ALTAIR-McGill-x-UVictoria/HAB-Control-Flight-Computer/README.md

# HAB-Control-Flight-Computer
High Altitude Balloon Flight Computer
