ALTAIR-McGill-x-UVictoria/HAB-Control-Flight-Computer/flight-computer-hardware/README.md

# Hardware Information

Flight computer PCB designed on KiCad, a free PCB design software.
