ALTAIR-McGill-x-UVictoria/HAB-Control-Flight-Computer/flight-computer-software/test/test_model/test_model_output_log.txt

=~=~=~=~=~=~=~=~=~=~=~= PuTTY log 2025.04.07 14:20:27 =~=~=~=~=~=~=~=~=~=~=~=
Successfully initialized all sensors.
ESCs ready
ESCs calibrated
Initializing TensorFlow Lite Micro Interpreter...
Model initialization done.
Starting mission...
time: 110023, xAcc: -0.02, yAcc: -0.01, vx: 0.17, vy: 0.02, px: 1.29, py: -0.08, roll: -0.06, pitch: -0.02, yaw: -1.04, xAngVel: 0.00, yAngVel: 0.01, zAngVel: 0.02, prevA0: 0.00, prevA1: 0.00, diffA0: 0.00, diffA1: 0.00, motor0: 0.52, motor1: 0.53
time: 110038, xAcc: -0.02, yAcc: -0.01, vx: 0.17, vy: 0.02, px: 1.29, py: -0.08, roll: -0.06, pitch: -0.02, yaw: -1.04, xAngVel: 0.01, yAngVel: 0.01, zAngVel: 0.01, prevA0: 0.52, prevA1: 0.53, diffA0: -0.52, diffA1: -0.53, motor0: 0.51, motor1: 0.53
time: 110045, xAcc: -0.02, yAcc: -0.01, vx: 0.17, vy: 0.01, px: 1.29, py: -0.08, roll: -0.06, pitch: -0.02, yaw: -1.04, xAngVel: 0.01, yAngVel: 0.01, zAngVel: 0.01, prevA0: 0.51, prevA1: 0.53, diffA0: 0.01, diffA1: -0.01, motor0: 0.52, motor1: 0.53
time: 110075, xAcc: -0.02, yAcc: -0.01, vx: 0.17, vy: 0.01, px: 1.30, py: -0.08, roll: -0.06, pitch: -0.02, yaw: -1.04, xAngVel: 0.01, yAngVel: 0.01, zAngVel: 0.01, prevA0: 0.52, prevA1: 0.53, diffA0: -0.00, diffA1: 0.00, motor0: 0.52, motor1: 0.53
time: 110103, xAcc: -0.02, yAcc: -0.01, vx: 0.17, vy: 0.01, px: 1.30, py: -0.08, roll: -0.06, pitch: -0.02, yaw: -1.04, xAngVel: 0.01, yAngVel: 0.01, zAngVel: 0.01, prevA0: 0.52, prevA1: 0.53, diffA0: 0.00, diffA1: -0.00, motor0: 0.52, motor1: 0.53
time: 110124, xAcc: -0.02, yAcc: -0.01, vx: 0.17, vy: 0.01, px: 1.31, py: -0.07, roll: -0.06, pitch: -0.02, yaw: -1.04, xAngVel: 0.00, yAngVel: 0.01, zAngVel: 0.01, prevA0: 0.52, prevA1: 0.53, diffA0: -0.00, diffA1: 0.00, motor0: 0.52, motor1: 0.53
time: 110140, xAcc: -0.02, yAcc: -0.01, vx: 0.17, vy: 0.01, px: 1.31, py: -0.07, roll: -0.06, pitch: -0.02, yaw: -1.04, xAngVel: 0.00, yAngVel: 0.01, zAngVel: 0.01, prevA0: 0.52, prevA1: 0.53, diffA0: -0.00, diffA1: 0.00, motor0: 0.52, motor1: 0.53
time: 110156, xAcc: -0.02, yAcc: -0.01, vx: 0.17, vy: 0.01, px: 1.31, py: -0.07, roll: -0.06, pitch: -0.02, yaw: -1.04, xAngVel: -0.00, yAngVel: 0.01, zAngVel: 0.02, prevA0: 0.52, prevA1: 0.53, diffA0: 0.00, diffA1: -0.00, motor0: 0.52, motor1: 0.53
time: 110183, xAcc: -0.02, yAcc: -0.01, vx: 0.16, vy: 0.01, px: 1.32, py: -0.07, roll: -0.06, pitch: -0.02, yaw: -1.04, xAngVel: -0.01, yAngVel: 0.01, zAngVel: 0.01, prevA0: 0.52, prevA1: 0.53, diffA0: -0.00, diffA1: -0.00, motor0: 0.52, motor1: 0.53
time: 110205, xAcc: -0.02, yAcc: -0.01, vx: 0.16, vy: 0.01, px: 1.32, py: -0.07, roll: -0.06, pitch: -0.02, yaw: -1.04, xAngVel: -0.01, yAngVel: 0.00, zAngVel: 0.01, prevA0: 0.52, prevA1: 0.53, diffA0: -0.00, diffA1: 0.00, motor0: 0.52, motor1: 0.53
time: 110222, xAcc: -0.02, yAcc: -0.01, vx: 0.16, vy: 0.01, px: 1.32, py: -0.07, roll: -0.06, pitch: -0.02, yaw: -1.04, xAngVel: -0.01, yAngVel: -0.00, zAngVel: 0.01, prevA0: 0.52, prevA1: 0.53, diffA0: -0.00, diffA1: -0.00, motor0: 0.52, motor1: 0.53
time: 110248, xAcc: -0.02, yAcc: -0.01, vx: 0.16, vy: 0.01, px: 1.33, py: -0.07, roll: -0.06, pitch: -0.02, yaw: -1.04, xAngVel: -0.01, yAngVel: -0.01, zAngVel: 0.01, prevA0: 0.52, prevA1: 0.53, diffA0: 0.00, diffA1: 0.00, motor0: 0.52, motor1: 0.53
time: 110266, xAcc: -0.02, yAcc: -0.01, vx: 0.16, vy: 0.01, px: 1.33, py: -0.07, roll: -0.06, pitch: -0.02, yaw: -1.04, xAngVel: -0.01, yAngVel: -0.01, zAngVel: 0.01, prevA0: 0.52, prevA1: 0.53, diffA0: -0.00, diffA1: 0.00, motor0: 0.52, motor1: 0.53
time: 110286, xAcc: -0.02, yAcc: -0.01, vx: 0.16, vy: 0.01, px: 1.33, py: -0.07, roll: -0.06, pitch: -0.02, yaw: -1.04, xAngVel: -0.02, yAngVel: 0.00, zAngVel: 0.01, prevA0: 0.52, prevA1: 0.53, diffA0: 0.00, diffA1: -0.00, motor0: 0.52, motor1: 0.53
time: 110301, xAcc: -0.03, yAcc: -0.00, vx: 0.16, vy: 0.01, px: 1.33, py: -0.07, roll: -0.06, pitch: -0.02, yaw: -1.04, xAngVel: -0.02, yAngVel: 0.01, zAngVel: 0.01, prevA0: 0.52, prevA1: 0.53, diffA0: -0.00, diffA1: -0.00, motor0: 0.52, motor1: 0.53
time: 110330, xAcc: -0.03, yAcc: -0.00, vx: 0.16, vy: 0.01, px: 1.34, py: -0.07, roll: -0.06, pitch: -0.02, yaw: -1.04, xAngVel: -0.02, yAngVel: 0.01, zAngVel: 0.01, prevA0: 0.52, prevA1: 0.53, diffA0: 0.00, diffA1: -0.00, motor0: 0.52, motor1: 0.53
time: 110352, xAcc: 0.01, yAcc: 0.01, vx: 0.16, vy: 0.01, px: 1.34, py: -0.07, roll: -0.06, pitch: -0.02, yaw: -1.04, xAngVel: -0.01, yAngVel: 0.01, zAngVel: 0.01, prevA0: 0.52, prevA1: 0.53, diffA0: -0.00, diffA1: 0.00, motor0: 0.52, motor1: 0.53
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
time: 112872, xAcc: -0.00, yAcc: -0.01, vx: 0.20, vy: -0.00, px: 1.75, py: -0.05, roll: -0.04, pitch: -0.01, yaw: -1.04, xAngVel: -0.00, yAngVel: -0.00, zAngVel: 0.01, prevA0: 0.52, prevA1: 0.53, diffA0: -0.00, diffA1: 0.00, motor0: 0.52, motor1: 0.53
time: 112889, xAcc: -0.03, yAcc: -0.01, vx: 0.20, vy: -0.00, px: 1.75, py: -0.05, roll: -0.04, pitch: -0.01, yaw: -1.04, xAngVel: 0.02, yAngVel: 0.00, zAngVel: 0.02, prevA0: 0.52, prevA1: 0.53, diffA0: -0.00, diffA1: 0.00, motor0: 0.52, motor1: 0.53
time: 112905, xAcc: -0.03, yAcc: -0.01, vx: 0.20, vy: -0.00, px: 1.75, py: -0.05, roll: -0.04, pitch: -0.01, yaw: -1.04, xAngVel: 0.00, yAngVel: -0.00, zAngVel: 0.01, prevA0: 0.52, prevA1: 0.53, diffA0: -0.00, diffA1: -0.00, motor0: 0.52, motor1: 0.53
time: 112925, xAcc: -0.03, yAcc: -0.01, vx: 0.20, vy: -0.00, px: 1.76, py: -0.05, roll: -0.04, pitch: -0.01, yaw: -1.04, xAngVel: 0.01, yAngVel: -0.00, zAngVel: 0.01, prevA0: 0.52, prevA1: 0.53, diffA0: -0.00, diffA1: 0.00, motor0: 0.52, motor1: 0.53
time: 112942, xAcc: -0.03, yAcc: -0.01, vx: 0.20, vy: -0.00, px: 1.76, py: -0.05, roll: -0.04, pitch: -0.01, yaw: -1.04, xAngVel: 0.00, yAngVel: 0.00, zAngVel: 0.03, prevA0: 0.52, prevA1: 0.53, diffA0: -0.00, diffA1: 0.00, motor0: 0.52, motor1: 0.53
time: 112971, xAcc: -0.03, yAcc: -0.01, vx: 0.20, vy: -0.00, px: 1.77, py: -0.05, roll: -0.04, pitch: -0.01, yaw: -1.04, xAngVel: -0.02, yAngVel: 0.01, zAngVel: 0.07, prevA0: 0.52, prevA1: 0.53, diffA0: 0.00, diffA1: -0.00, motor0: 0.52, motor1: 0.53
time: 112990, xAcc: -0.03, yAcc: -0.01, vx: 0.20, vy: -0.00, px: 1.77, py: -0.05, roll: -0.04, pitch: -0.01, yaw: -1.04, xAngVel: 0.00, yAngVel: 0.02, zAngVel: 0.08, prevA0: 0.52, prevA1: 0.53, diffA0: 0.00, diffA1: -0.00, motor0: 0.52, motor1: 0.53
time: 113000, xAcc: -0.03, yAcc: -0.01, vx: 0.20, vy: -0.01, px: 1.77, py: -0.05, roll: -0.04, pitch: -0.01, yaw: -1.04, xAngVel: -0.00, yAngVel: 0.03, zAngVel: 0.11, prevA0: 0.52, prevA1: 0.53, diffA0: 0.00, diffA1: -0.00, motor0: 0.52, motor1: 0.53
time: 113005, xAcc: -0.03, yAcc: -0.01, vx: 0.20, vy: -0.01, px: 1.77, py: -0.05, roll: -0.04, pitch: -0.01, yaw: -1.04, xAngVel: 0.02, yAngVel: 0.04, zAngVel: 0.16, prevA0: 0.52, prevA1: 0.53, diffA0: 0.00, diffA1: -0.00, motor0: 0.52, motor1: 0.53
time: 113021, xAcc: -0.22, yAcc: 0.06, vx: 0.19, vy: -0.00, px: 1.78, py: -0.05, roll: -0.03, pitch: -0.01, yaw: -1.03, xAngVel: 0.02, yAngVel: 0.05, zAngVel: 0.18, prevA0: 0.52, prevA1: 0.53, diffA0: 0.00, diffA1: -0.00, motor0: 0.52, motor1: 0.53
time: 113048, xAcc: -0.22, yAcc: 0.06, vx: 0.19, vy: -0.00, px: 1.78, py: -0.05, roll: -0.03, pitch: -0.01, yaw: -1.03, xAngVel: 0.02, yAngVel: 0.04, zAngVel: 0.20, prevA0: 0.52, prevA1: 0.53, diffA0: -0.00, diffA1: 0.00, motor0: 0.52, motor1: 0.53
time: 113076, xAcc: -0.22, yAcc: 0.06, vx: 0.18, vy: -0.00, px: 1.79, py: -0.05, roll: -0.03, pitch: -0.01, yaw: -1.03, xAngVel: 0.02, yAngVel: 0.04, zAngVel: 0.20, prevA0: 0.52, prevA1: 0.53, diffA0: 0.00, diffA1: -0.00, motor0: 0.52, motor1: 0.53
time: 113089, xAcc: -0.22, yAcc: 0.06, vx: 0.18, vy: -0.00, px: 1.79, py: -0.05, roll: -0.03, pitch: -0.01, yaw: -1.03, xAngVel: 0.06, yAngVel: 0.05, zAngVel: 0.24, prevA0: 0.52, prevA1: 0.53, diffA0: -0.00, diffA1: 0.00, motor0: 0.52, motor1: 0.53
time: 113095, xAcc: -0.22, yAcc: 0.06, vx: 0.18, vy: -0.00, px: 1.79, py: -0.05, roll: -0.03, pitch: -0.01, yaw: -1.03, xAngVel: 0.06, yAngVel: 0.04, zAngVel: 0.28, prevA0: 0.52, prevA1: 0.53, diffA0: 0.00, diffA1: -0.00, motor0: 0.52, motor1: 0.53
time: 113100, xAcc: -0.22, yAcc: 0.07, vx: 0.17, vy: 0.00, px: 1.79, py: -0.05, roll: -0.03, pitch: -0.02, yaw: -1.03, xAngVel: 0.07, yAngVel: 0.04, zAngVel: 0.28, prevA0: 0.52, prevA1: 0.53, diffA0: 0.00, diffA1: -0.00, motor0: 0.52, motor1: 0.53
time: 113126, xAcc: -0.07, yAcc: -0.07, vx: 0.17, vy: -0.00, px: 1.80, py: -0.05, roll: -0.03, pitch: -0.02, yaw: -1.03, xAngVel: 0.09, yAngVel: 0.05, zAngVel: 0.29, prevA0: 0.52, prevA1: 0.53, diffA0: -0.00, diffA1: 0.00, motor0: 0.52, motor1: 0.53
time: 113154, xAcc: -0.07, yAcc: -0.07, vx: 0.17, vy: -0.00, px: 1.80, py: -0.05, roll: -0.03, pitch: -0.02, yaw: -1.01, xAngVel: 0.09, yAngVel: 0.05, zAngVel: 0.29, prevA0: 0.52, prevA1: 0.53, diffA0: 0.00, diffA1: -0.00, motor0: 0.52, motor1: 0.53
time: 113174, xAcc: -0.07, yAcc: -0.07, vx: 0.17, vy: -0.00, px: 1.81, py: -0.05, roll: -0.03, pitch: -0.02, yaw: -1.01, xAngVel: 0.11, yAngVel: 0.04, zAngVel: 0.30, prevA0: 0.52, prevA1: 0.53, diffA0: 0.00, diffA1: -0.00, motor0: 0.52, motor1: 0.53
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
time: 115472, xAcc: 0.07, yAcc: -0.04, vx: 0.21, vy: 0.01, px: 2.24, py: -0.06, roll: -0.03, pitch: -0.02, yaw: -1.43, xAngVel: 0.07, yAngVel: -0.06, zAngVel: 0.17, prevA0: 0.52, prevA1: 0.53, diffA0: -0.00, diffA1: -0.00, motor0: 0.52, motor1: 0.53
time: 115493, xAcc: -0.12, yAcc: -0.05, vx: 0.21, vy: 0.01, px: 2.24, py: -0.06, roll: -0.03, pitch: -0.02, yaw: -1.43, xAngVel: 0.06, yAngVel: -0.06, zAngVel: 0.17, prevA0: 0.52, prevA1: 0.53, diffA0: 0.00, diffA1: -0.00, motor0: 0.52, motor1: 0.53
time: 115510, xAcc: -0.12, yAcc: -0.05, vx: 0.21, vy: 0.01, px: 2.24, py: -0.06, roll: -0.03, pitch: -0.02, yaw: -1.43, xAngVel: 0.05, yAngVel: -0.05, zAngVel: 0.18, prevA0: 0.52, prevA1: 0.53, diffA0: -0.00, diffA1: 0.00, motor0: 0.52, motor1: 0.53
time: 115526, xAcc: -0.12, yAcc: -0.05, vx: 0.21, vy: 0.01, px: 2.25, py: -0.06, roll: -0.03, pitch: -0.02, yaw: -1.43, xAngVel: 0.06, yAngVel: -0.04, zAngVel: 0.19, prevA0: 0.52, prevA1: 0.53, diffA0: 0.00, diffA1: -0.00, motor0: 0.52, motor1: 0.53
time: 115543, xAcc: -0.12, yAcc: -0.05, vx: 0.21, vy: 0.01, px: 2.25, py: -0.06, roll: -0.03, pitch: -0.02, yaw: -1.43, xAngVel: 0.05, yAngVel: -0.04, zAngVel: 0.19, prevA0: 0.52, prevA1: 0.53, diffA0: 0.00, diffA1: -0.00, motor0: 0.52, motor1: 0.53
time: 115561, xAcc: -0.12, yAcc: -0.05, vx: 0.20, vy: 0.01, px: 2.26, py: -0.06, roll: -0.03, pitch: -0.02, yaw: -1.43, xAngVel: 0.04, yAngVel: -0.03, zAngVel: 0.18, prevA0: 0.52, prevA1: 0.53, diffA0: -0.00, diffA1: 0.00, motor0: 0.52, motor1: 0.53
time: 115579, xAcc: -0.12, yAcc: -0.05, vx: 0.20, vy: 0.01, px: 2.26, py: -0.06, roll: -0.03, pitch: -0.02, yaw: -1.43, xAngVel: 0.01, yAngVel: -0.04, zAngVel: 0.17, prevA0: 0.52, prevA1: 0.53, diffA0: -0.00, diffA1: 0.00, motor0: 0.52, motor1: 0.53
time: 115606, xAcc: -0.12, yAcc: -0.05, vx: 0.20, vy: 0.00, px: 2.26, py: -0.06, roll: -0.03, pitch: -0.02, yaw: -1.43, xAngVel: -0.00, yAngVel: -0.03, zAngVel: 0.18, prevA0: 0.52, prevA1: 0.53, diffA0: -0.00, diffA1: 0.00, motor0: 0.52, motor1: 0.53
time: 115629, xAcc: -0.12, yAcc: -0.05, vx: 0.19, vy: 0.00, px: 2.27, py: -0.06, roll: -0.03, pitch: -0.02, yaw: -1.43, xAngVel: -0.00, yAngVel: -0.03, zAngVel: 0.18, prevA0: 0.52, prevA1: 0.53, diffA0: -0.00, diffA1: -0.00, motor0: 0.52, motor1: 0.53
time: 115638, xAcc: -0.12, yAcc: -0.05, vx: 0.19, vy: 0.00, px: 2.27, py: -0.06, roll: -0.03, pitch: -0.02, yaw: -1.43, xAngVel: -0.01, yAngVel: -0.03, zAngVel: 0.18, prevA0: 0.52, prevA1: 0.53, diffA0: -0.00, diffA1: -0.00, motor0: 0.52, motor1: 0.53
time: 115656, xAcc: -0.12, yAcc: -0.05, vx: 0.19, vy: 0.00, px: 2.27, py: -0.06, roll: -0.03, pitch: -0.02, yaw: -1.43, xAngVel: -0.04, yAngVel: -0.03, zAngVel: 0.18, prevA0: 0.52, prevA1: 0.53, diffA0: 0.00, diffA1: -0.00, motor0: 0.52, motor1: 0.53
time: 115683, xAcc: -0.11, yAcc: 0.07, vx: 0.19, vy: 0.00, px: 2.28, py: -0.06, roll: -0.04, pitch: -0.03, yaw: -0.38, xAngVel: -0.04, yAngVel: 0.02, zAngVel: 0.18, prevA0: 0.52, prevA1: 0.53, diffA0: -0.00, diffA1: 0.00, motor0: 0.52, motor1: 0.53
time: 115711, xAcc: -0.11, yAcc: 0.07, vx: 0.18, vy: 0.00, px: 2.28, py: -0.06, roll: -0.04, pitch: -0.03, yaw: -0.38, xAngVel: -0.03, yAngVel: 0.03, zAngVel: 0.19, prevA0: 0.52, prevA1: 0.53, diffA0: 0.00, diffA1: -0.00, motor0: 0.52, motor1: 0.53
time: 115725, xAcc: -0.11, yAcc: 0.07, vx: 0.18, vy: 0.00, px: 2.28, py: -0.06, roll: -0.04, pitch: -0.03, yaw: -0.38, xAngVel: -0.04, yAngVel: 0.04, zAngVel: 0.18, prevA0: 0.52, prevA1: 0.53, diffA0: -0.00, diffA1: 0.00, motor0: 0.52, motor1: 0.53
time: 115732, xAcc: -0.11, yAcc: 0.07, vx: 0.18, vy: 0.01, px: 2.29, py: -0.06, roll: -0.04, pitch: -0.03, yaw: -0.38, xAngVel: -0.05, yAngVel: 0.04, zAngVel: 0.17, prevA0: 0.52, prevA1: 0.53, diffA0: -0.00, diffA1: 0.00, motor0: 0.52, motor1: 0.53
time: 115762, xAcc: -0.11, yAcc: 0.07, vx: 0.18, vy: 0.01, px: 2.29, py: -0.06, roll: -0.05, pitch: -0.02, yaw: -0.38, xAngVel: -0.04, yAngVel: 0.04, zAngVel: 0.17, prevA0: 0.52, prevA1: 0.53, diffA0: -0.00, diffA1: 0.00, motor0: 0.52, motor1: 0.53
time: 115790, xAcc: -0.11, yAcc: 0.07, vx: 0.18, vy: 0.01, px: 2.30, py: -0.06, roll: -0.05, pitch: -0.02, yaw: -0.37, xAngVel: -0.04, yAngVel: 0.05, zAngVel: 0.18, prevA0: 0.52, prevA1: 0.53, diffA0: -0.00, diffA1: 0.00, motor0: 0.52, motor1: 0.53
time: 115811, xAcc: -0.11, yAcc: 0.07, vx: 0.17, vy: 0.01, px: 2.30, py: -0.06, roll: -0.05, pitch: -0.02, yaw: -0.37, xAngVel: -0.02, yAngVel: 0.04, zAngVel: 0.19, prevA0: 0.52, prevA1: 0.53, diffA0: 0.00, diffA1: -0.00, motor0: 0.52, motor1: 0.53
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
time: 124649, xAcc: -0.08, yAcc: 0.02, vx: 0.17, vy: 0.01, px: 3.36, py: 0.12, roll: -0.05, pitch: -0.01, yaw: -0.33, xAngVel: 0.01, yAngVel: 0.01, zAngVel: 0.02, prevA0: 0.52, prevA1: 0.53, diffA0: 0.00, diffA1: 0.00, motor0: 0.52, motor1: 0.53
time: 124675, xAcc: -0.08, yAcc: 0.02, vx: 0.17, vy: 0.02, px: 3.36, py: 0.12, roll: -0.05, pitch: -0.01, yaw: -0.33, xAngVel: 0.02, yAngVel: 0.01, zAngVel: 0.04, prevA0: 0.52, prevA1: 0.53, diffA0: 0.00, diffA1: -0.00, motor0: 0.52, motor1: 0.53
time: 124704, xAcc: -0.12, yAcc: 0.12, vx: 0.16, vy: 0.02, px: 3.37, py: 0.12, roll: -0.05, pitch: -0.01, yaw: -0.33, xAngVel: 0.02, yAngVel: 0.01, zAngVel: 0.03, prevA0: 0.52, prevA1: 0.53, diffA0: 0.00, diffA1: -0.00, motor0: 0.52, motor1: 0.53
time: 124717, xAcc: -0.12, yAcc: 0.12, vx: 0.16, vy: 0.02, px: 3.37, py: 0.12, roll: -0.05, pitch: -0.01, yaw: -0.33, xAngVel: 0.03, yAngVel: -0.01, zAngVel: 0.05, prevA0: 0.52, prevA1: 0.53, diffA0: -0.00, diffA1: 0.00, motor0: 0.52, motor1: 0.53
time: 124725, xAcc: -0.12, yAcc: 0.12, vx: 0.16, vy: 0.02, px: 3.37, py: 0.12, roll: -0.05, pitch: -0.01, yaw: -0.33, xAngVel: 0.03, yAngVel: -0.00, zAngVel: 0.04, prevA0: 0.52, prevA1: 0.53, diffA0: 0.00, diffA1: -0.00, motor0: 0.52, motor1: 0.53
time: 124749, xAcc: -0.12, yAcc: 0.12, vx: 0.16, vy: 0.02, px: 3.37, py: 0.12, roll: -0.05, pitch: -0.01, yaw: -0.33, xAngVel: 0.03, yAngVel: -0.00, zAngVel: 0.03, prevA0: 0.52, prevA1: 0.53, diffA0: -0.00, diffA1: 0.00, motor0: 0.52, motor1: 0.53
time: 124777, xAcc: -0.12, yAcc: 0.12, vx: 0.16, vy: 0.03, px: 3.38, py: 0.12, roll: -0.04, pitch: -0.02, yaw: -0.33, xAngVel: 0.03, yAngVel: -0.00, zAngVel: 0.03, prevA0: 0.52, prevA1: 0.53, diffA0: -0.00, diffA1: 0.00, motor0: 0.52, motor1: 0.53
time: 124799, xAcc: 0.00, yAcc: 0.03, vx: 0.16, vy: 0.03, px: 3.38, py: 0.12, roll: -0.04, pitch: -0.02, yaw: -0.33, xAngVel: 0.02, yAngVel: -0.00, zAngVel: 0.03, prevA0: 0.52, prevA1: 0.53, diffA0: -0.00, diffA1: 0.00, motor0: 0.52, motor1: 0.53
time: 124816, xAcc: 0.00, yAcc: 0.03, vx: 0.16, vy: 0.03, px: 3.38, py: 0.12, roll: -0.04, pitch: -0.02, yaw: -0.33, xAngVel: 0.03, yAngVel: -0.03, zAngVel: 0.04, prevA0: 0.52, prevA1: 0.53, diffA0: 0.00, diffA1: -0.00, motor0: 0.52, motor1: 0.53
time: 124832, xAcc: 0.00, yAcc: 0.03, vx: 0.16, vy: 0.03, px: 3.39, py: 0.12, roll: -0.04, pitch: -0.02, yaw: -0.33, xAngVel: 0.04, yAngVel: -0.04, zAngVel: 0.05, prevA0: 0.52, prevA1: 0.53, diffA0: 0.00, diffA1: -0.00, motor0: 0.52, motor1: 0.53
time: 124849, xAcc: 0.00, yAcc: 0.03, vx: 0.16, vy: 0.03, px: 3.39, py: 0.12, roll: -0.04, pitch: -0.02, yaw: -0.33, xAngVel: 0.04, yAngVel: -0.03, zAngVel: 0.04, prevA0: 0.52, prevA1: 0.53, diffA0: 0.00, diffA1: -0.00, motor0: 0.52, motor1: 0.53
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
