ALTAIR-McGill-x-UVictoria/HAB-Control-Flight-Computer/(threads)

Thread 1 (2025-01-13):

Design the flight software architecture

PersoSirEduard, 2025-01-13:

PersoSirEduard, 2025-02-12:
### Comments

- Motor rotation cannot be tested under current assumptions within the FSM (the current approach would be to use a visual test for the motors since the ESC chosen does not seem to be sending feedback data)
- For data writes upon boot to the SD card, the data should be logged and not wiped out every time there is a power off or boot sequence
- Keep latest state in EEPROM in case of power outage
- Ascending can be determined based on short acceleration and altitude change
- On encountering a problem, it can either lead to a warning or fault. Fault then brings the system to termination
- Keep an array of booleans that tells you the status of each sensor. In this way for example, you can have the log function print locally but also on telemetry if it finds the device works

Thread 2 (2025-02-12):

Implement Telemetry API for SPI Communication

PersoSirEduard, 2025-02-12:
Write a small library to allow SPI communication between the flight computer board and the power/telemetry board.

[API Datasheet](https://docs.google.com/spreadsheets/d/1BPyfOt_OemiA3UXY2QvG065G2Qh49tt0MnBQY9HR62w/edit?usp=sharing)

### Flight Computer --> Power Board
Field Name | Description | Data Type | Byte Offset | Size (Bytes)
-- | -- | -- | -- | --
Timestamp | Time of data capture | uint32 | 0x00 | 4
Pressure | Atmospheric pressure | uint32 | 0x04 | 4
Temperature | Temperature probe reading | uint32 | 0x08 | 4
Acceleration X | X-axis acceleration | float32 | 0x0C | 4
Acceleration Y | Y-axis acceleration | float32 | 0x10 | 4
Acceleration Z | Z-axis acceleration | float32 | 0x14 | 4
Velocity X | X-axis velocity | float32 | 0x18 | 4
Velocity Y | Y-axis velocity | float32 | 0x1C | 4
Velocity Z | Z-axis velocity | float32 | 0x20 | 4
Battery Voltage | Voltage value of battery | float32 | 0x24 | 4
Latitude | GPS latitude | float32 | 0x28 | 4
Longitude | GPS longitude | float32 | 0x2C | 4
Status Msg Length | Length of the variable data section | uint16 | 0x2E | 2
Status Msg | Extra data with dynamic length | byte[] | 0x30 | Msg Length
Checksum | Error detection | uint16 | 0x30 + Msg Length | 2

Closed 2025-03-10.

Thread 6 (2025-02-12):

Implement Data Collection

PersoSirEduard, 2025-02-12:
- Read/Write on the SD Card
- SD card should be initialized in the Initialization state. If it fails to initialize, it should transition into the Fault state.
- Use the available features boolean array to periodically collect data from sensors and store it on the SD card.
- Requires implementing a function to log the sensors' status.

A13XBGA, 2025-03-13:
- Additional considerations: Base implementaiton of data_collection_thread was implemented with @aptrott, although after some code review with @PersoSirEduard, it would be a good idea to not open and close the file every time we want to write to the SD card in case the timing doesn't allow for all the data to be written, a suggestion could be to open it once in the thread (outside the while loop) and then write the data inside the while loop, it remains to be tested whether or not the current implementation faces issues.

Thread 7 (2025-02-12):

Implement the Flight Computer FSM

PersoSirEduard, 2025-02-12:
- Implement state transition and management

Reference code:
```c
#include <Arduino.h>
#include <TeensyThreads.h>

// Define FSM states
enum State {
    INIT, CALIBRATION, TESTING, NORMAL_FLIGHT,
    MOTOR_ENGAGEMENT, WARNING, ABORTION, TERMINATION
};

State currentState = INIT;

// Threads
Threads threads;
void vStateMachineTask();
void vSensorTask();
void vLoggingTask();

// Simulated sensor readings
float altitude = 0.0;
bool sensorFailure = false;
bool motorEngaged = false;

// Function prototypes
void transitionTo(State newState);
void performActionForState();
void readSensors();
void logData();
void engageMotors();
void terminateFlight();

void setup() {
    Serial.begin(115200);
    threads.addThread(vStateMachineTask);
    threads.addThread(vSensorTask);
    threads.addThread(vLoggingTask);
}

void loop() {}

void vStateMachineTask() {
    while (1) {
        performActionForState();
        threads.delay(500);
    }
}

void vSensorTask() {
    while (1) {
        readSensors();
        threads.delay(1000);
    }
}

void vLoggingTask() {
    while (1) {
        logData();
        threads.delay(2000);
    }
}

void transitionTo(State newState) {
    Serial.print("Transitioning to state: ");
    Serial.println(newState);
    currentState = newState;
}

void performActionForState() {
    switch (currentState) {
        case INIT:
            Serial.println("Initializing...");
            transitionTo(CALIBRATION);
            break;
        case CALIBRATION:
            Serial.println("Calibrating sensors...");
            transitionTo(TESTING);
            break;
        case TESTING:
            Serial.println("Performing system tests...");
            transitionTo(NORMAL_FLIGHT);
            break;
        case NORMAL_FLIGHT:
            Serial.println("Normal flight mode.");
            if (altitude >= 20000) transitionTo(MOTOR_ENGAGEMENT);
            if (sensorFailure) transitionTo(WARNING);
            break;
        case MOTOR_ENGAGEMENT:
            engageMotors();
            threads.delay(30000);
            transitionTo(NORMAL_FLIGHT);
            break;
        case WARNING:
            Serial.println("Warning! Checking sensors...");
            if (sensorFailure) transitionTo(ABORTION);
            else transitionTo(NORMAL_FLIGHT);
            break;
        case ABORTION:
            Serial.println("Aborting mission...");
            transitionTo(TERMINATION);
            break;
        case TERMINATION:
            terminateFlight();
            break;
    }
}

void readSensors() {
    altitude += 1000; // Simulating altitude gain
    if (altitude > 25000) sensorFailure = true;
}

void logData() {
    Serial.print("Logging data: Altitude = ");
    Serial.println(altitude);
}

void engageMotors() {
    Serial.println("Engaging motors for 30s...");
    motorEngaged = true;
    threads.delay(30000);
    motorEngaged = false;
}

void terminateFlight() {
    Serial.println("Flight terminated. Motors OFF.");
    while (1);
}
```

Closed 2025-04-11.

Thread 9 (2025-02-12):

Implement Telemetry State Task

PersoSirEduard, 2025-02-12:
The Telemetry task should run in a separate thread from the main state machine once the system is initialized. To communicate with the telemetry task, a thread-safe queue is used where the telemetry task periodically checks.

A13XBGA, 2025-02-13:
- 2 states:

- Telemetry Hold
- Telemetry, which will contain most of the code for the SPI communication

Closed 2025-03-24.

Thread 10 (2025-02-17):

Failsafe sensors with the FC software

lilibegin, 2025-02-17:
- make sure it is detecting when an sensor gets disconnected

Closed 2025-02-23.

Thread 11 (2025-02-23):

debug why flight computer software doesn't work with 2 sensors disconnected then reconnected

lilibegin, 2025-02-23:
Basically, when one sensor is disconnected and reconnected flight computer software works as it should

However when two sensors are disconnected, and one reconnected it just stops printing. figure out why and fix this

Closed 2025-03-31.

Thread 16 (2025-03-24):

Add world frame sensor transformation for sensors library

PersoSirEduard, 2025-03-24:
#include <Arduino.h>
#include <Wire.h>

// Structure to hold 3D vectors
struct Vector3 {
  float x;
  float y;
  float z;
};

// Structure to hold quaternions
struct Quaternion {
  float w;  // Scalar part
  float x;  // Vector part (i)
  float y;  // Vector part (j)
  float z;  // Vector part (k)
};

// Function to normalize a quaternion
void normalizeQuaternion(Quaternion &q) {
  float magnitude = sqrt(q.w * q.w + q.x * q.x + q.y * q.y + q.z * q.z);
  if (magnitude > 0.0001f) {
    q.w /= magnitude;
    q.x /= magnitude;
    q.y /= magnitude;
    q.z /= magnitude;
  }
}

// Function to calculate the conjugate of a quaternion
Quaternion quaternionConjugate(const Quaternion &q) {
  Quaternion result;
  result.w = q.w;
  result.x = -q.x;
  result.y = -q.y;
  result.z = -q.z;
  return result;
}

// Function to multiply two quaternions
Quaternion quaternionMultiply(const Quaternion &q1, const Quaternion &q2) {
  Quaternion result;

  result.w = q1.w * q2.w - q1.x * q2.x - q1.y * q2.y - q1.z * q2.z;
  result.x = q1.w * q2.x + q1.x * q2.w + q1.y * q2.z - q1.z * q2.y;
  result.y = q1.w * q2.y - q1.x * q2.z + q1.y * q2.w + q1.z * q2.x;
  result.z = q1.w * q2.z + q1.x * q2.y - q1.y * q2.x + q1.z * q2.w;

  return result;
}

// Function to convert a vector to a pure quaternion
Quaternion vectorToQuaternion(const Vector3 &v) {
  Quaternion result;
  result.w = 0.0f;
  result.x = v.x;
  result.y = v.y;
  result.z = v.z;
  return result;
}

// Function to extract vector part from a quaternion
Vector3 quaternionToVector(const Quaternion &q) {
  Vector3 result;
  result.x = q.x;
  result.y = q.y;
  result.z = q.z;
  return result;
}

// Function to convert IMU frame measurements to world frame
void convertToWorldFrame(
  const Vector3 &accelImu,
  const Vector3 &gyroImu,
  const Quaternion &orientation,
  Vector3 &accelWorld,
  Vector3 &gyroWorld
) {
  // Make a copy of the orientation quaternion and normalize it
  Quaternion q = orientation;
  normalizeQuaternion(q);

  // Calculate the conjugate (inverse for unit quaternions)
  Quaternion qConj = quaternionConjugate(q);

  // Convert acceleration to pure quaternion
  Quaternion accelQuat = vectorToQuaternion(accelImu);

  // Convert angular velocity to pure quaternion
  Quaternion gyroQuat = vectorToQuaternion(gyroImu);

  // Perform quaternion rotation: q * a * q^(-1)
  Quaternion accelWorldQuat = quaternionMultiply(
    quaternionMultiply(q, accelQuat),
    qConj
  );

  Quaternion gyroWorldQuat = quaternionMultiply(
    quaternionMultiply(q, gyroQuat),
    qConj
  );

  // Extract vector part of the resulting quaternion
  accelWorld = quaternionToVector(accelWorldQuat);
  gyroWorld = quaternionToVector(gyroWorldQuat);
}

// Example usage in a Teensy 4.1 sketch
void setup() {
  Serial.begin(115200);
  while (!Serial) {
    // Wait for serial port to connect
    delay(10);
  }

  Serial.println("IMU World Frame Conversion Example");

  // Initialize your IMU sensor here
  // wire.begin();
  // myIMU.begin();
}

void loop() {
  // These would normally come from your IMU sensor
  Vector3 accelImu = {0.1f, 0.2f, 9.8f};  // Example values
  Vector3 gyroImu = {0.01f, 0.02f, 0.03f};  // Example values
  Quaternion orientation = {0.7071f, 0.0f, 0.7071f, 0.0f};  // Example orientation (45 degrees around Y)

  // Variables to store world frame results
  Vector3 accelWorld;
  Vector3 gyroWorld;

  // Convert to world frame
  convertToWorldFrame(accelImu, gyroImu, orientation, accelWorld, gyroWorld);

  // Print results
  Serial.println("IMU Frame:");
  Serial.print("  Accel: "); Serial.print(accelImu.x); Serial.print(", ");
  Serial.print(accelImu.y); Serial.print(", "); Serial.println(accelImu.z);
  Serial.print("  Gyro: "); Serial.print(gyroImu.x); Serial.print(", ");
  Serial.print(gyroImu.y); Serial.print(", "); Serial.println(gyroImu.z);

  Serial.println("World Frame:");
  Serial.print("  Accel: "); Serial.print(accelWorld.x); Serial.print(", ");
  Serial.print(accelWorld.y); Serial.print(", "); Serial.println(accelWorld.z);
  Serial.print("  Gyro: "); Serial.print(gyroWorld.x); Serial.print(", ");
  Serial.print(gyroWorld.y); Serial.print(", "); Serial.println(gyroWorld.z);

  delay(1000);
}

Closed 2025-03-31.
