ALTAIR-McGill-x-UVictoria/HAB-Control-Flight-Computer/flight-computer-hardware/flight-computer-pcb/ecse_controls_flight_computer.kicad_pcb

## KiCad design flight-computer-hardware/flight-computer-pcb/ecse_controls_flight_computer.kicad_pcb (2025-02-16)

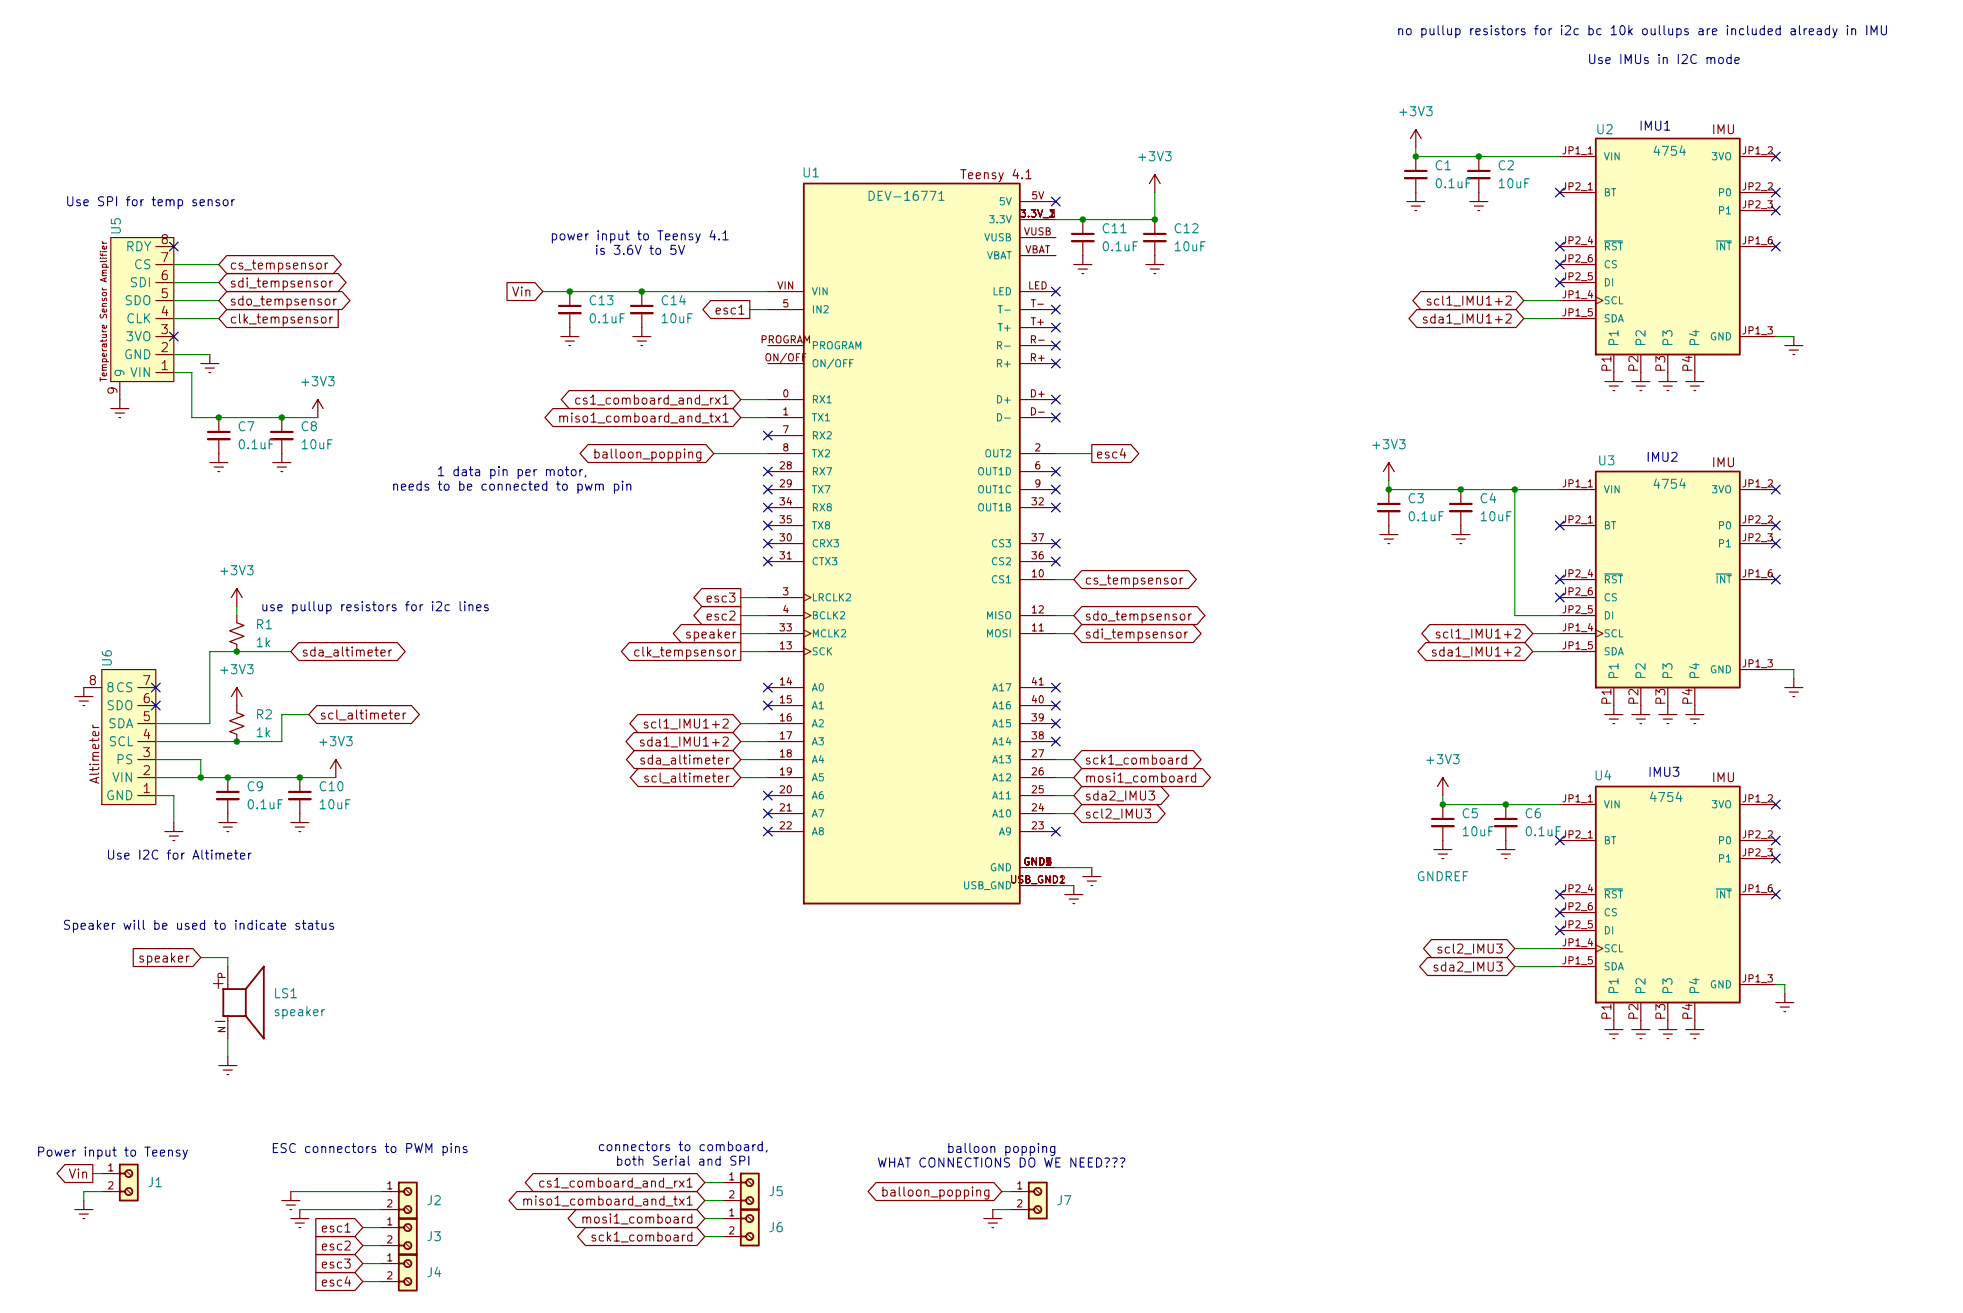
[picture p1: schematic ecse_controls_flight_computer.kicad_sch]

Parts:
C1, C3, C6, C7, C9, C11, C13: 0.1uF; C_0805_2012Metric_Pad1.18x1.45mm_HandSolder
C2, C4, C5, C8, C10, C12, C14: 10uF; C_0805_2012Metric_Pad1.18x1.45mm_HandSolder
J1, J2, J3, J4, J5, J6, J7: 691137710002; 691137710002-connector; PART-NUMBER 691137710002
LS1: speaker; PARTREV C
R1, R2: 1k; R_0805_2012Metric_Pad1.20x1.40mm_HandSolder
U1: DEV-16771; MODULE_DEV-16771; PARTREV 4.1
U2, U3, U4: 4754; MODULE_4754; PARTREV 2021-03-16
U5: temperature-amplifier
U6: altimeter

Connections:
+3V3: C1.1, C2.1, C3.1, C4.1, C5.1, C6.1, C7.1, C8.1, C9.1, C10.1, C11.1, C12.1, R1.1, R2.1, U1.3.3V_1 (3.3V), U1.3.3V_2 (3.3V), U1.3.3V_3 (3.3V), U2.JP1_1 (VIN), U3.JP1_1 (VIN), U3.JP2_5 (DI), U4.JP1_1 (VIN), U5.1 (VIN), U6.2 (VIN), U6.3 (PS)
GNDREF: C1.2, C2.2, C3.2, C4.2, C5.2, C6.2, C7.2, C8.2, C9.2, C10.2, C11.2, C12.2, C13.2, C14.2, J1.2, J2.1, J2.2, J7.2, LS1.N, U1.GND1 (GND), U1.GND2 (GND), U1.GND3 (GND), U1.GND4 (GND), U1.GND5 (GND), U1.USB_GND1 (USB_GND), U1.USB_GND2 (USB_GND), U2.JP1_3 (GND), U2.P1, U2.P2, U2.P3, U2.P4, U3.JP1_3 (GND), U3.P1, U3.P2, U3.P3, U3.P4, U4.JP1_3 (GND), U4.P1, U4.P2, U4.P3, U4.P4, U5.2 (GND), U5.9, U6.1 (GND), U6.8
Vin: C13.1, C14.1, J1.1, U1.VIN
balloon_popping: J7.1, U1.8 (TX2)
clk_tempsensor: U1.13 (SCK), U5.4 (CLK)
cs1_comboard_and_rx1: J5.1, U1.0 (RX1)
cs_tempsensor: U1.10 (CS1), U5.7 (CS)
esc1: J3.1, U1.5 (IN2)
esc2: J3.2, U1.4 (BCLK2)
esc3: J4.1, U1.3 (LRCLK2)
esc4: J4.2, U1.2 (OUT2)
miso1_comboard_and_tx1: J5.2, U1.1 (TX1)
mosi1_comboard: J6.1, U1.26 (A12)
sck1_comboard: J6.2, U1.27 (A13)
scl1_IMU1+2: U1.16 (A2), U2.JP1_4 (SCL), U3.JP1_4 (SCL)
scl2_IMU3: U1.24 (A10), U4.JP1_4 (SCL)
scl_altimeter: R2.2, U1.19 (A5), U6.4 (SCL)
sda1_IMU1+2: U1.17 (A3), U2.JP1_5 (SDA), U3.JP1_5 (SDA)
sda2_IMU3: U1.25 (A11), U4.JP1_5 (SDA)
sda_altimeter: R1.2, U1.18 (A4), U6.5 (SDA)
sdi_tempsensor: U1.11 (MOSI), U5.6 (SDI)
sdo_tempsensor: U1.12 (MISO), U5.5 (SDO)
speaker: LS1.P, U1.33 (MCLK2)

Notes on the sheet:
IMU3
use pullup resistors for i2c lines
IMU2
power input to Teensy 4.1 is 3.6V to 5V
Use I2C for Altimeter
connectors to comboard, both Serial and SPI
Use IMUs in I2C mode
balloon popping WHAT CONNECTIONS DO WE NEED???
Use SPI for temp sensor
no pullup resistors for i2c bc 10k oullups are included already in IMU
ESC connectors to PWM pins
1 data pin per motor, needs to be connected to pwm pin
Speaker will be used to indicate status
IMU1
Power input to Teensy

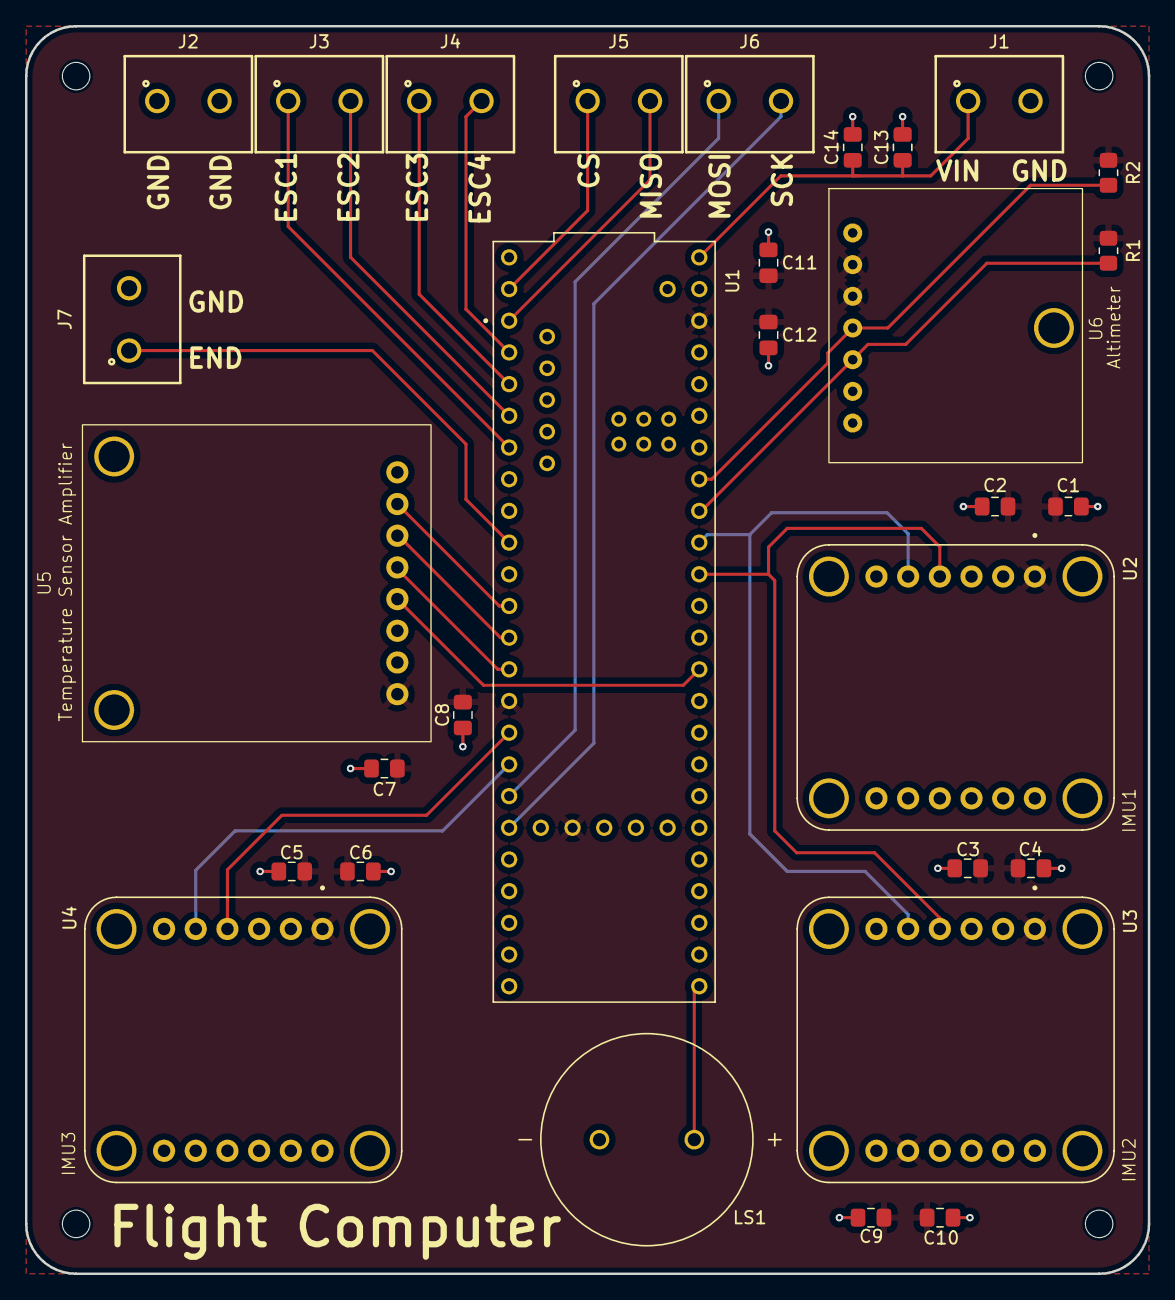
[picture p2: board ecse_controls_flight_computer.kicad_pcb from above]

Board: 2 copper layers, 90.0 x 100.0 mm, 30 parts (0 on the bottom side), 23 nets.
