ALTAIR-McGill-x-UVictoria/HAB-Control-Flight-Computer/flight-computer-software/test/test_threading_tensorflow/test_threading_tensorflow.cpp

/*
 *  This is a test program for using ArduTFLite within a TeensyThreads thread.
 *  Using the sine model example from the ArduTFLite hello world example.
 */



 
 /* Copyright 2024 Chirale, TensorFlow Authors. All Rights Reserved.

This sketch is derived from the classic Hello World example of the general 
TensorFlow Lite Micro library. It has been adapted and simplified by Chirale 
to conform to the typical style of Arduino sketches. 
It has been tested on an Arduino Nano 33 BLE.
The sketch implements a Deep Neural Network pre-trained on calculating 
the function sin(x). 
By sending a value between 0 and 2*Pi via the Serial Monitor, 
both the value inferred by the DNN model and the actual value 
calculated using the Arduino math library are displayed.

It shows how to use ArduTFlite Library to run a TensorFlow Lite model.

For more information read the library documentation 
at: https://github.com/spaziochirale/ArduTFLite

Licensed under the Apache License, Version 2.0 (the "License");
you may not use this file except in compliance with the License.
You may obtain a copy of the License at

    http://www.apache.org/licenses/LICENSE-2.0

Unless required by applicable law or agreed to in writing, software
distributed under the License is distributed on an "AS IS" BASIS,
WITHOUT WARRANTIES OR CONDITIONS OF ANY KIND, either express or implied.
See the License for the specific language governing permissions and
limitations under the License.
==============================================================================*/

// include main library header file
#include <ArduTFLite.h>

// include static array definition of pre-trained model
#include "model.h"

#include "TeensyThreads.h"

// The Tensor Arena memory area is used by TensorFlow Lite to store input, output and intermediate tensors
// It must be defined as a global array of byte (or u_int8 which is the same type on Arduino) 
// The Tensor Arena size must be defined by trials and errors. We use here a quite large value.
// The alignas(16) directive is used to ensure that the array is aligned on a 16-byte boundary,
// this is important for performance and to prevent some issues on ARM microcontroller architectures.
constexpr int kTensorArenaSize = 2000;
alignas(16) uint8_t tensor_arena[kTensorArenaSize];

const int LED = 13;
volatile int blinkcode = 0;

int count = 0;

void countthread(){
  while(1){
    count++;
    blinkcode = count;
    threads.delay(5000);
    threads.yield();
  }
}

void blinkthread() {
  while(1) {
    if (blinkcode) {
      for (int i=0; i<blinkcode; i++) {
        digitalWrite(LED, HIGH);
        threads.delay(150);
        digitalWrite(LED, LOW);
        threads.delay(150);
      }
      blinkcode = 0;
    }
    threads.yield();
  }
}

void modelthread() {
  while(1){
    // Check if a value was sent from Serial Monitor
    // if so, 'sanitize' the input and perform inference
    if (Serial.available()){
      String inputValue = Serial.readString();
      float x = inputValue.toFloat(); // evaluates to zero if the user input is not a valid number
      Serial.print("Your input value: ");
      Serial.println(x);
      // The model was trained in range 0 to 2*Pi
      // if the value provided by user is not in this range
      // the value is corrected substituting edge values
      if (x<0) x = 0;
      if (x >6.28) x = 6.28;
      Serial.print("Adapted input value: ");
      Serial.println(x);
    
      // Place the value in the model's input tensor
      modelSetInput(x,0);

      // Run inference, and report if an error occurs
      if(!modelRunInference()){
            Serial.println("RunInference Failed!");
            return;
          }

      // Obtain the output from model's output tensor
      
      float y = modelGetOutput(0);

      Serial.print("Inferred Sin of ");
      Serial.print(x);
      Serial.print(" = ");
      Serial.println(y,2);
      Serial.print("Actual Sin of ");
      Serial.print(x);
      Serial.print(" = ");
      Serial.println(sin(x),2);

    }
    threads.yield();
  }
  
}

void setup() {
  delay(1000);
  pinMode(LED, OUTPUT);
  threads.addThread(blinkthread);
  threads.addThread(countthread);
  // Initialize serial communications and wait for Serial Monitor to be opened
  Serial.begin(9600);
  while(!Serial);

  Serial.println("Sine(x) function inference example.");
  Serial.println("Initializing TensorFlow Lite Micro Interpreter...");
  if (!modelInit(model, tensor_arena, kTensorArenaSize)){
    Serial.println("Model initialization failed!");
    while(true);
  }
  Serial.println("Model initialization done.");

  Serial.println("");
  Serial.println("Please, input a float number between 0 and 6.28");
  threads.addThread(modelthread);
}

void loop() {

}
