ALTAIR-McGill-x-UVictoria/HAB-Control-Flight-Computer/(commit log)

2025-02-12 added initial structure, sensor wrapper, and tests
2025-02-13 changed to project to PlatformIO from ArduinoIDE, updated project structure, added configs for test envs, and created readme for instructions
2025-02-15 Create Flight Computer PCB
2025-02-15 Rename Flight Computer PCB to Flight Computer PCB folder/Flight computer kicad
2025-02-15 added some code for sensor fusion (NOT TESTED YET)
2025-02-16 fixed hardware directory and added sensor fusion for IMUS (median filtering)
    [ecse_controls_flight_computer.kicad_pcb, ecse_controls_flight_computer.kicad_sch]
2025-02-16 implemented Weighted Average sensor fusion to compare with Median filtering
2025-02-23 detect if imu gets disconnected in sensorFusion function, commented code in header file
2025-03-04 added angular velocity, made sensorfusion function private
2025-03-04 creating first iteration of SPI communication protocol between ECSE power and ECSE control boards, testing pending
2025-03-04 deleted renamed test file for power board
2025-03-04 deleted renamed test file for control board
2025-03-04 added extra printing statements for confirmation
2025-03-04 testing status of SPI
2025-03-04 added more print statements
2025-03-05 still not working yet, trying to get the angular velocity from the orientation (using functions getAngularVelocity and calculateAngularVelocity
    [Sensors.cpp, Sensors.h, test_sensors_output.cpp]
2025-03-05 Added state machine framework
2025-03-06 updated sensors class to work for linear acceleration, angular velocity, and orientation simultaneously
2025-03-06 identified issue and solved using threads
    [Sensors.cpp, Sensors.h, test_sensors_output.cpp]
2025-03-07 fully working sensor class with threading
2025-03-07 added imu data invalidation after timeout to check for disconnection
2025-03-07 imu and alitmeter detect when disconnected
2025-03-08 added delay to determine if timing is too short between SPI messages
2025-03-09 created simpler test to faciliate debugging for SPI
2025-03-09 added delay to simple comm power test
2025-03-09 added modified SPI library that supports slave mode and updated simple test code
2025-03-09 added SPI.begin() call for debugging purposes
2025-03-09 testing pin configuration
2025-03-09 edited code to test serial connection instead of SPI using sample test code
2025-03-10 deleted previous directory for spi control board
2025-03-10 deleted previous header for SPI communication (no longer in use)
2025-03-10 deleted previous SPI library (no longer in use)
2025-03-11 added check for imu i2c begin
2025-03-18 improved sensor class with status checking and restart logic
2025-03-18 fixed sensor status tracking to only restart altimeter if it fails since the IMUs cannot work this way after some testing
    [Sensors.cpp, Sensors.h]
2025-03-18 cleaned up sensors code
2025-03-19 sensors code improvements
2025-03-20 corrected some errors in the main file
    [main.cpp]
2025-03-30 team coding session, completed main except for stabilization and motor control
2025-03-31 added world frame conversions to sensors class
